hasithvm/ikea-vindriktning-addon/docs/README.md

# IKEA Vindriktning Sensor Add-on Board
[][cc-by-sa]

This repo contains all the resources for an add-on board for an IKEA Vindriktning sensor that adds wireless connectivity via an ESP8266 module and two additional sensors (SGP30, BME280) for more detailed air quality metrics.

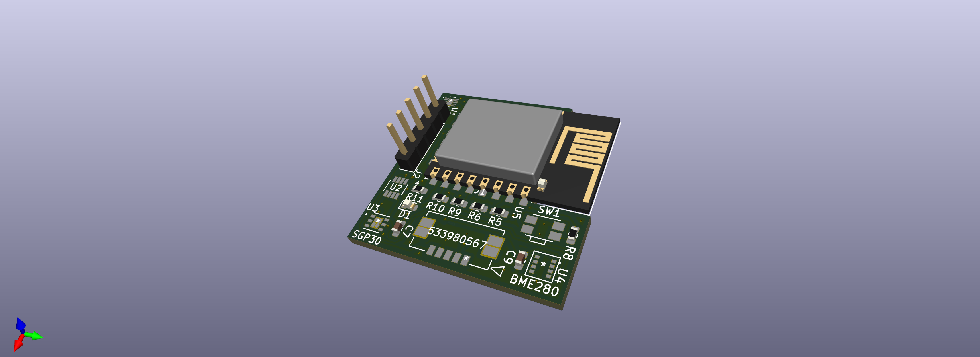
[picture p1: docs/vindriktning-addon-board.png]
Board Render


This work is licensed under a
[Creative Commons Attribution-ShareAlike 4.0 International License][cc-by-sa].

[][cc-by-sa]

[cc-by-sa]: http://creativecommons.org/licenses/by-sa/4.0/
[cc-by-sa-image]: https://licensebuttons.net/l/by-sa/4.0/88x31.png
[cc-by-sa-shield]: https://img.shields.io/badge/License-CC%20BY--SA%204.0-lightgrey.svg
