hasithvm/ikea-vindriktning-addon/board/vindriktning-addon-board.kicad_pcb

## KiCad design board/vindriktning-addon-board.kicad_pcb (2022-11-13)

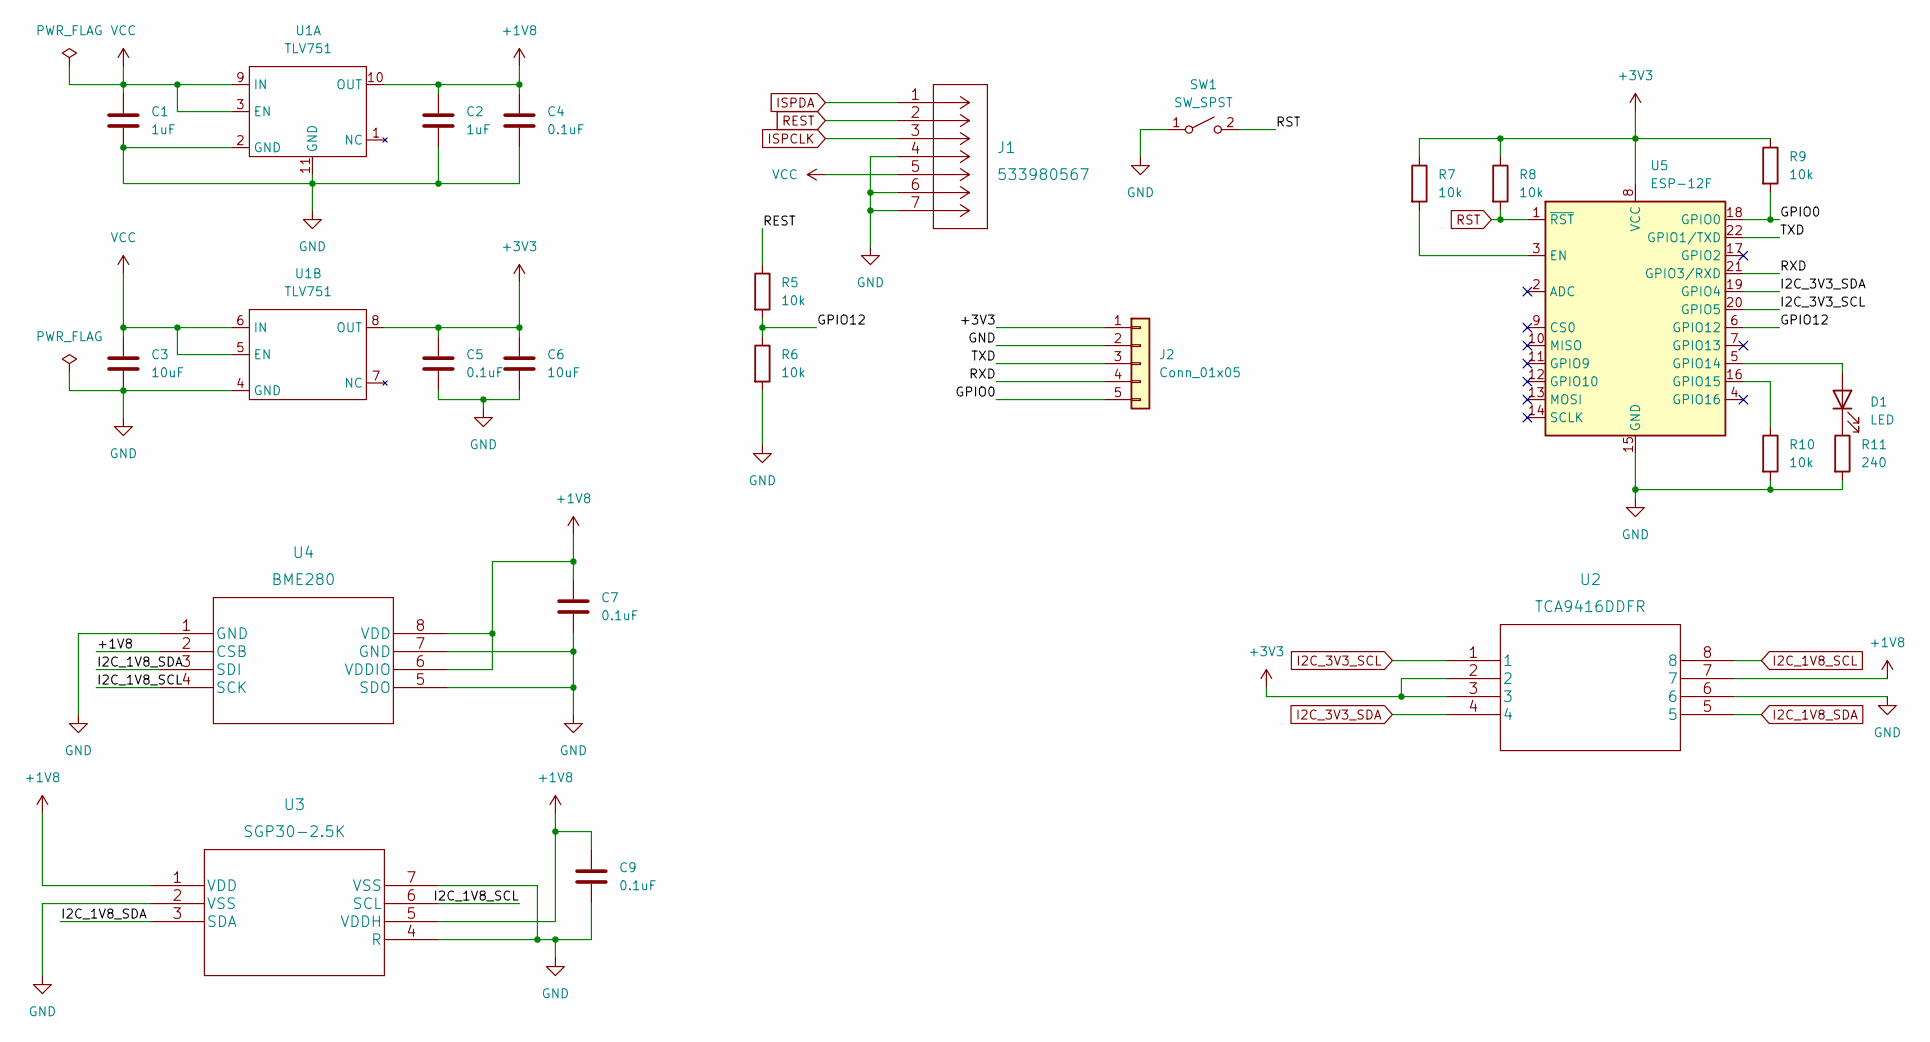
[picture p2: schematic vindriktning-addon-board.kicad_sch]

Parts:
C1, C2: 1uF; C_0603_1608Metric
C3, C6: 10uF; C_0805_2012Metric
C4, C5, C7, C9: 0.1uF; C_0603_1608Metric
D1: LED; LED_0603_1608Metric
J1: 533980567
J2: Conn_01x05; PinHeader_1x05_P2.54mm_Vertical
R5, R6, R7, R8, R9, R10: 10k; R_0603_1608Metric
R11: 240; R_0603_1608Metric
SW1: SW_SPST; SW_SPST_EVQP7A
U1: TLV751; TLV75101PDSQR
U2: TCA9416DDFR
U3: SGP30-2.5K
U4: BME280
U5: ESP-12F; ESP-12E

Connections:
+1V8: C2.1, C4.1, C7.1, C9.1, U1.10 (OUT), U2.7, U3.1 (VDD), U3.5 (VDDH), U4.2 (CSB), U4.6 (VDDIO), U4.8 (VDD)
+3V3: C5.1, C6.1, J2.1, R7.1, R8.1, R9.1, U1.8 (OUT), U2.2, U2.3, U5.8 (VCC)
/GPIO0: J2.5, R9.2, U5.18 (GPIO0)
/GPIO12: R5.2, R6.1, U5.6 (GPIO12)
/RXD: J2.4, U5.21 (GPIO3/RXD)
/TXD: J2.3, U5.22 (GPIO1/TXD)
GND: C1.2, C2.2, C3.2, C4.2, C5.2, C6.2, C7.2, C9.2, J1.4, J1.6, J1.7, J2.2, R6.2, R10.2, R11.2, SW1.1 (A), U1.2 (GND), U1.4 (GND), U1.11 (GND), U2.6, U3.2 (VSS), U3.4 (R), U3.7 (VSS), U4.1 (GND), U4.5 (SDO), U4.7 (GND), U5.15 (GND)
I2C_1V8_SCL: U2.8, U3.6 (SCL), U4.4 (SCK)
I2C_1V8_SDA: U2.5, U3.3 (SDA), U4.3 (SDI)
I2C_3V3_SCL: U2.1, U5.20 (GPIO5)
I2C_3V3_SDA: U2.4, U5.19 (GPIO4)
ISPCLK: J1.3
ISPDA: J1.1
unnamed: D1.1 (K), R11.1
unnamed: D1.2 (A), U5.5 (GPIO14)
unnamed: R7.2, U5.3 (EN)
unnamed: R10.1, U5.16 (GPIO15)
REST: J1.2, R5.1
RST: R8.2, SW1.2 (B), U5.1 (~RST)
VCC: C1.1, C3.1, J1.5, U1.3 (EN), U1.5 (EN), U1.6 (IN), U1.9 (IN)

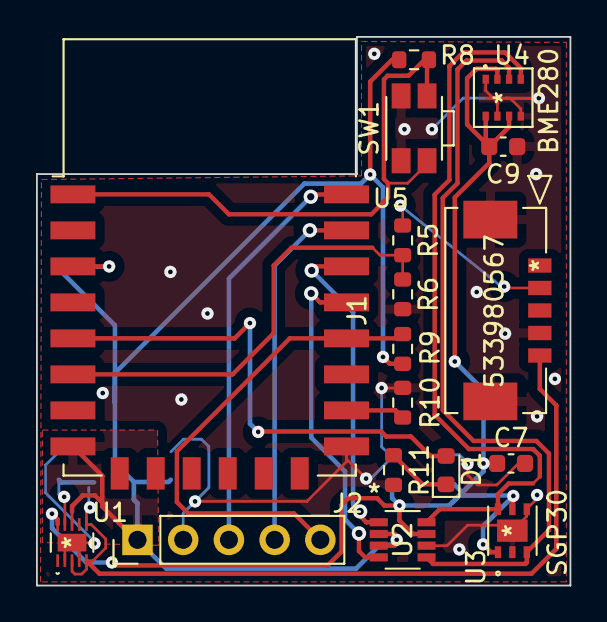
[picture p3: board vindriktning-addon-board.kicad_pcb from above]

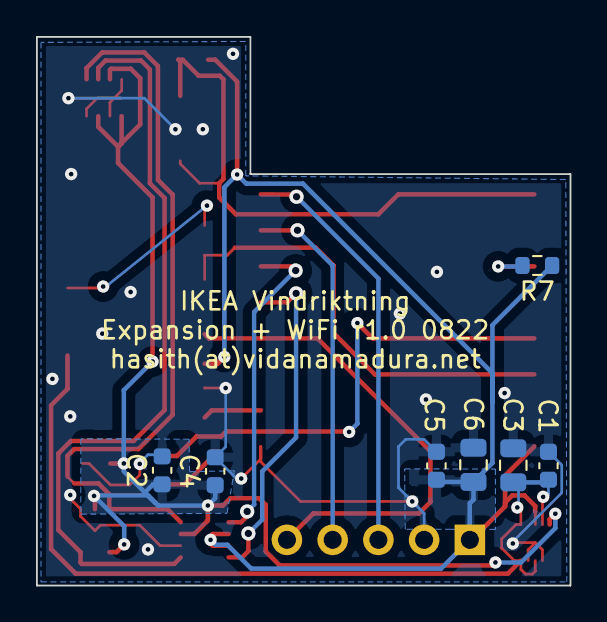
[picture p4: board vindriktning-addon-board.kicad_pcb from below]

Board: 2 copper layers, 29.6 x 30.5 mm, 24 parts (7 on the bottom side), 18 nets.
