hasithvm/ikea-vindriktning-addon/(commit log)

2022-11-13 v1 of board design, fabbed via OSHPark
    [vindriktning-addon-board-annotated.csv, vindriktning-addon-board.csv, vindriktning-addon-board.kicad_pcb, vindriktning-addon-board.kicad_sch]
2022-11-15 Adding device base YAML file
