hasithvm/ikea-vindriktning-addon/(notices)

Notices in the files:
docs/README.md:
CC BY-SA 4.0
parts and their libraries:
Copyright 2021 Accelerated Designs. All rights reserved.
